local-traffic/rpi5-windows-case/stl/connector.stl

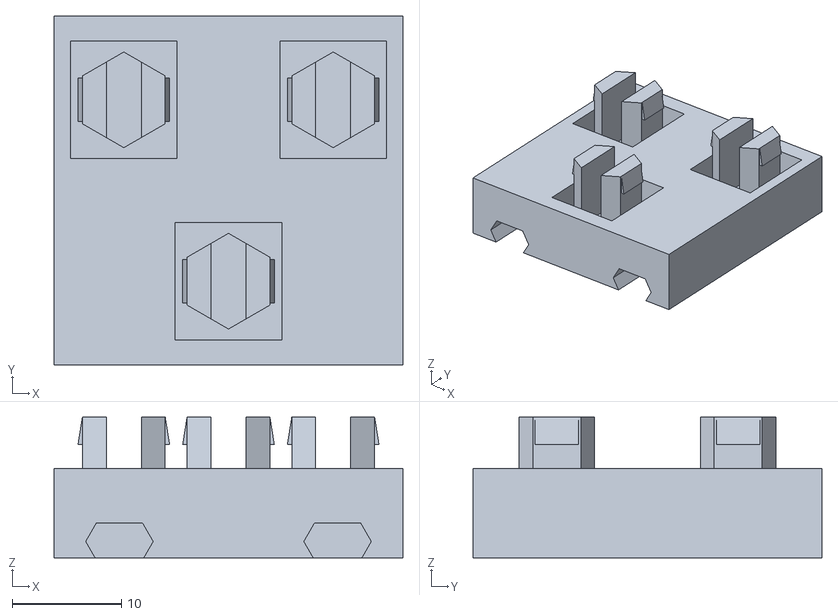
[picture p2: CAD file, 2026-10-30]
stl/connector.stl
32.0 x 32.0 x 12.9
