local-traffic/rpi5-windows-case/stl/cover.stl

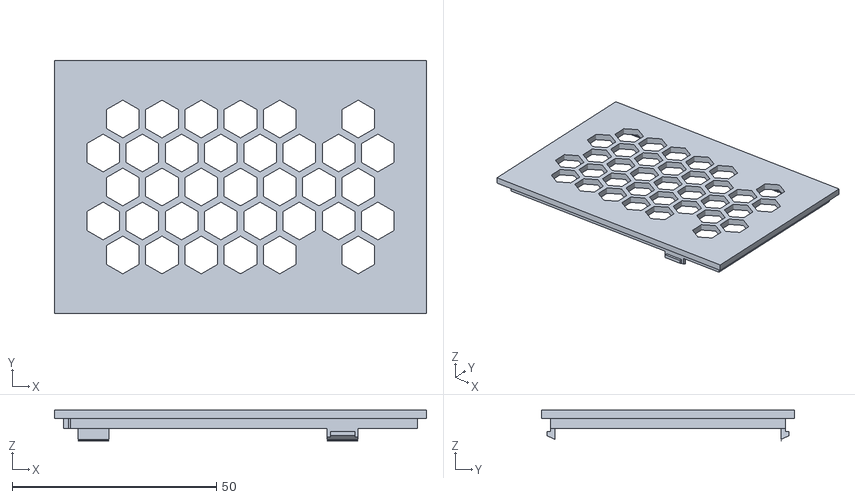
[picture p3: CAD file, 2026-10-30]
stl/cover.stl
91.0 x 62.0 x 7.50
