local-traffic/rpi5-windows-case/stl/window_pad.stl

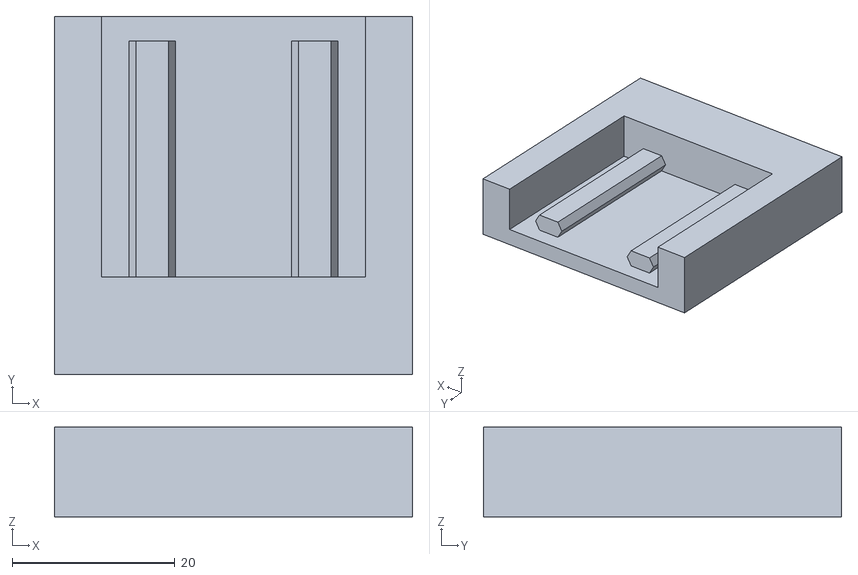
[picture p4: CAD file, 2026-10-30]
stl/window_pad.stl
44.0 x 44.0 x 11.0
