local-traffic/rpi5-windows-case/stl/cam_housing.stl

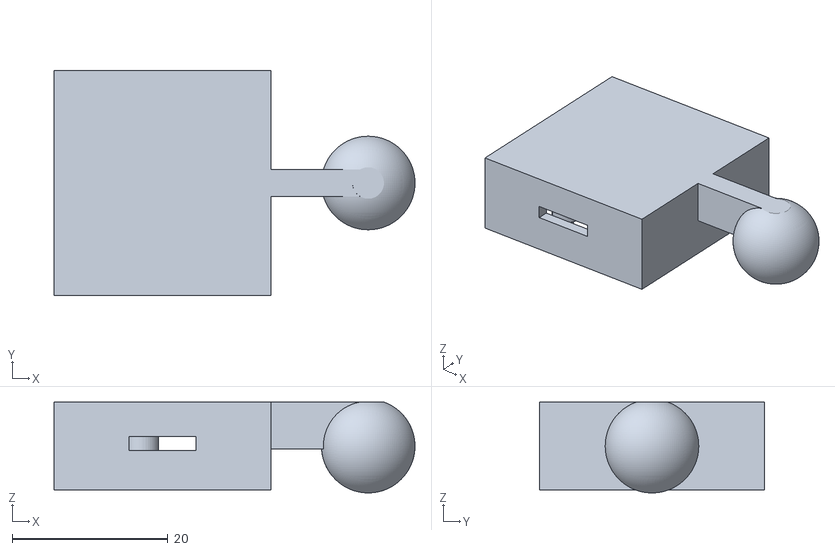
[picture p5: CAD file, 2026-10-30]
stl/cam_housing.stl
46.3 x 28.8 x 11.7
