local-traffic/rpi5-windows-case/stl/cam_lid.stl

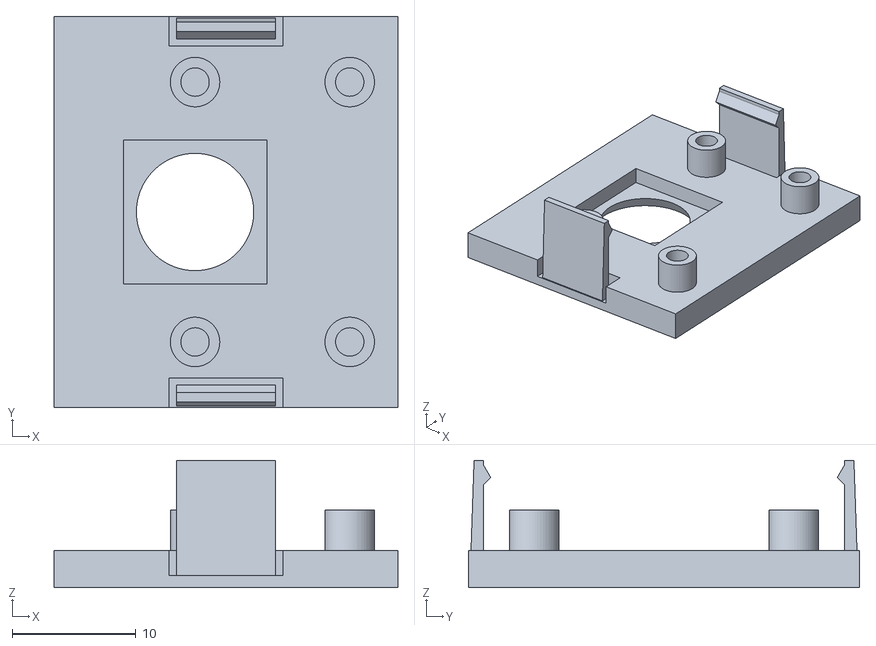
[picture p6: CAD file, 2026-10-30]
stl/cam_lid.stl
27.8 x 31.6 x 10.3
