local-traffic/rpi5-windows-case/stl/case.stl

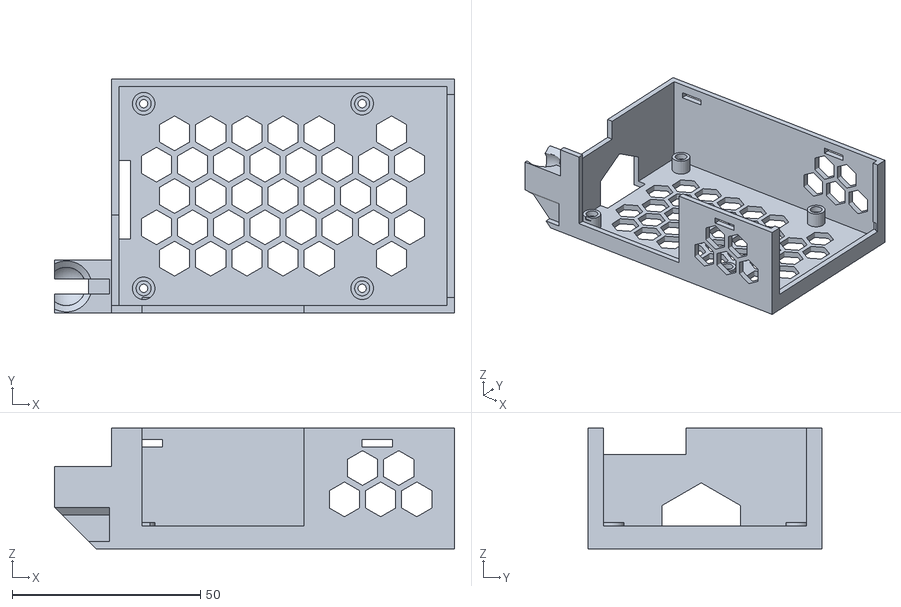
[picture p7: CAD file, 2026-10-30]
stl/case.stl
106.2 x 62.0 x 32.0
